AGB556/BISMUTH/CAD/Top Hot Assembly.stl

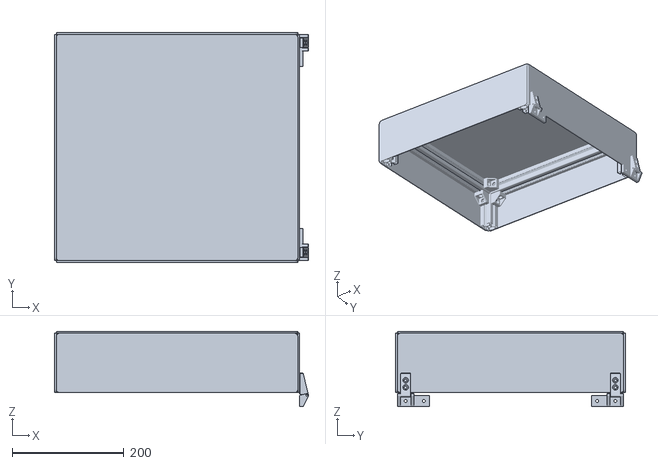
[picture p1: CAD file, 2024-08-06]
CAD/Top Hot Assembly.stl
454.0 x 411.1 x 134.4
