AGB556/BISMUTH/CAD/Hinge Assembly.step

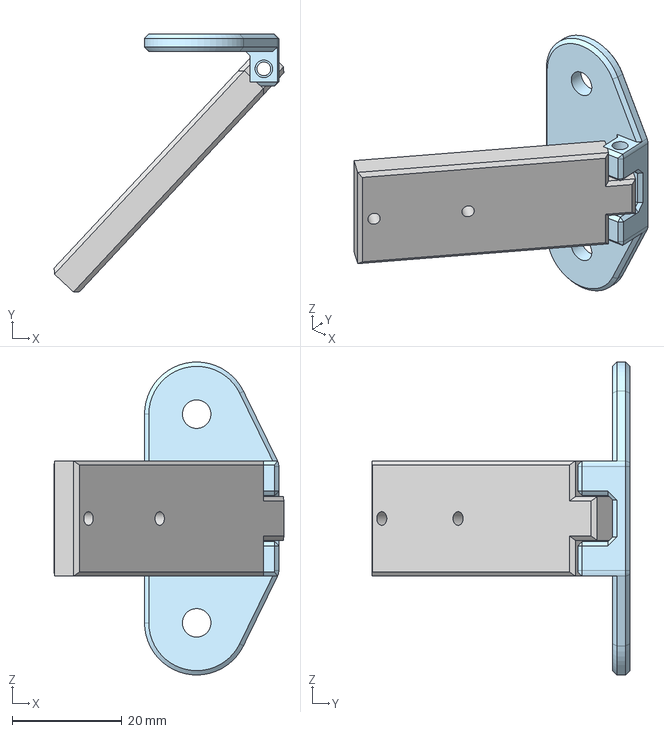
[picture p2: CAD file, 2024-07-04]
CAD/Hinge Assembly.step
41.9 x 47.1 x 57.1 mm
