AGB556/BISMUTH/CAD/Skirt Assembly.step

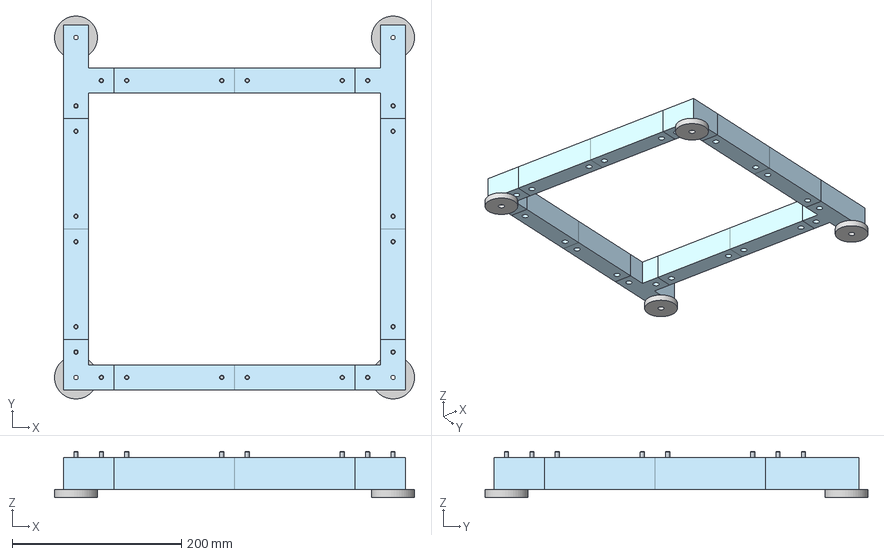
[picture p3: CAD file, 2024-07-02]
CAD/Skirt Assembly.step
425.6 x 452.6 x 54.5 mm
Hex socket head cap screw M5x0.80 x 25 x 24
