AGB556/BISMUTH/CAD/Anti Spool Cantilever.stl

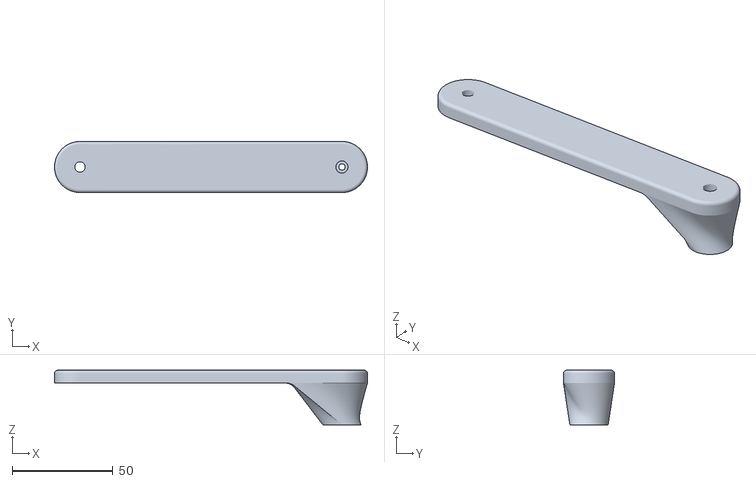
[picture p4: CAD file, 2024-08-18]
CAD/Anti Spool Cantilever.stl
155.6 x 25.4 x 27.2
