AGB556/BISMUTH/CAD/External Spool Holder.stl

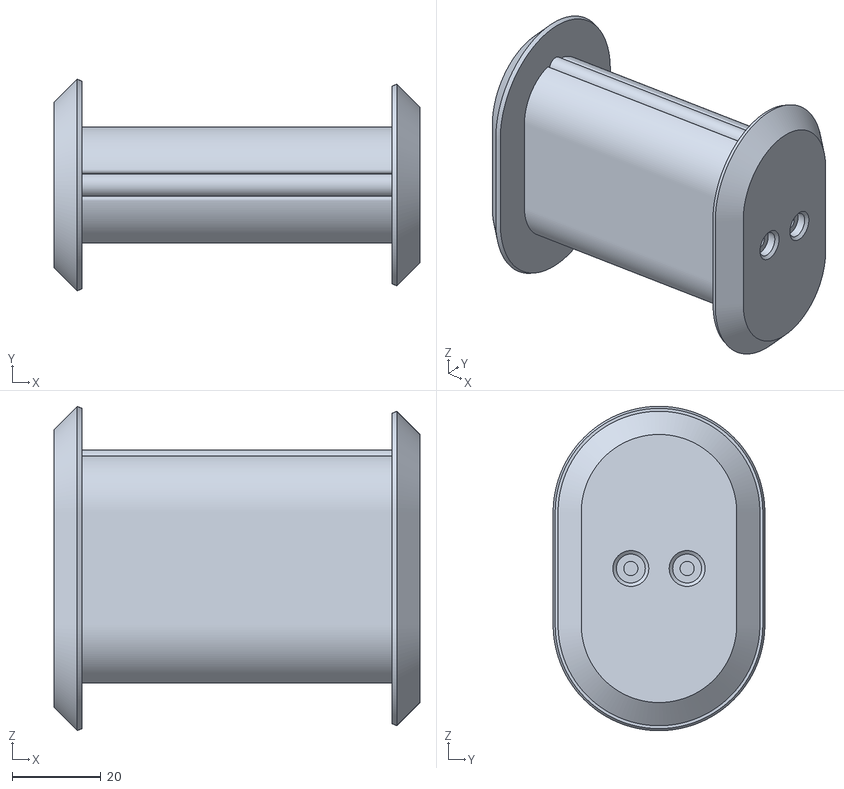
[picture p5: CAD file, 2024-08-16]
CAD/External Spool Holder.stl
82.5 x 47.8 x 73.2
