AGB556/BISMUTH/CAD/Spool.stl

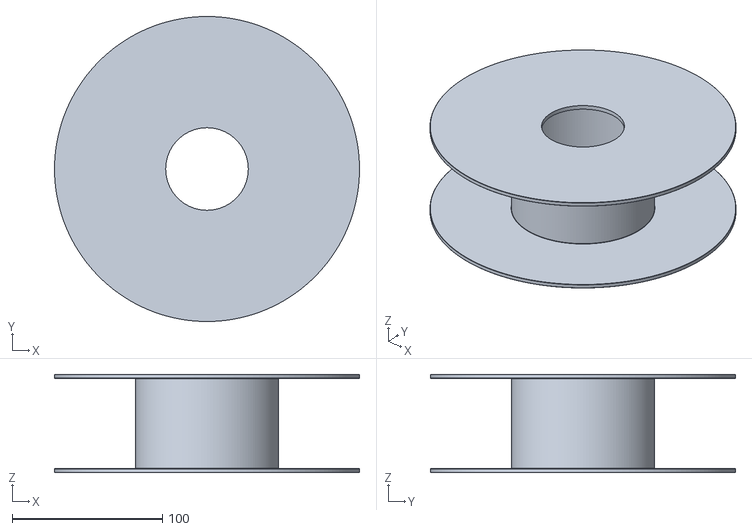
[picture p6: CAD file, 2024-08-16]
CAD/Spool.stl
203.2 x 203.2 x 65.5
