AGB556/BISMUTH/CAD/Top Electronics Panel.stl

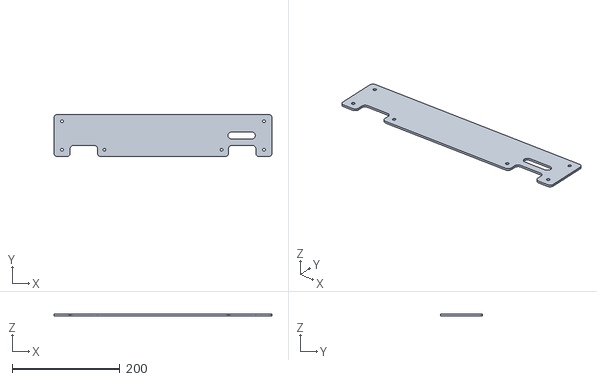
[picture p7: CAD file, 2024-08-15]
CAD/Top Electronics Panel.stl
404.8 x 78.5 x 3.17
