AGB556/BISMUTH/CAD/X-Y Parts - Sensorless Homing Block.stl

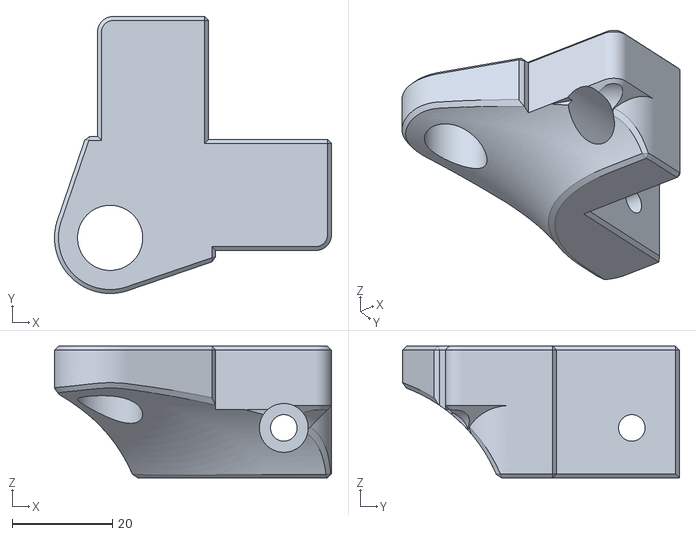
[picture p8: CAD file, 2024-08-14]
CAD/X-Y Parts - Sensorless Homing Block.stl
55.3 x 55.3 x 26.3
