AGB556/BISMUTH/CAD/Skirt Bottom Panel.stl

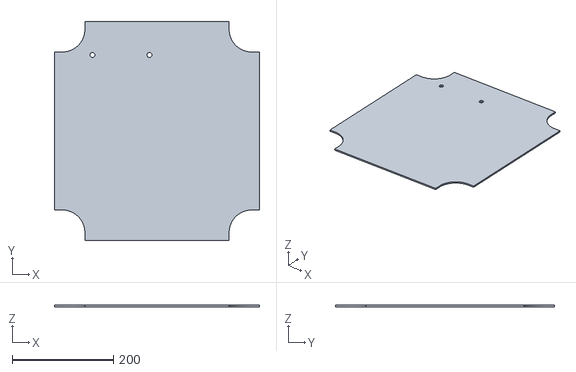
[picture p9: CAD file, 2024-08-13]
CAD/Skirt Bottom Panel.stl
404.8 x 431.8 x 3.17
