AGB556/BISMUTH/CAD/Bottom Panel.stl

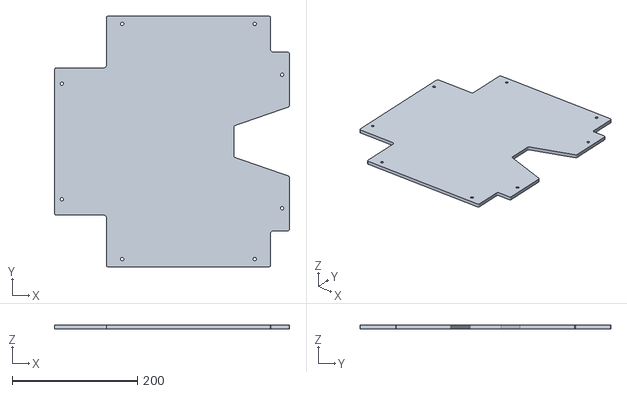
[picture p10: CAD file, 2024-08-13]
CAD/Bottom Panel.stl
374.6 x 400.1 x 6.35
