AGB556/BISMUTH/CAD/Door Hinge V3.stl

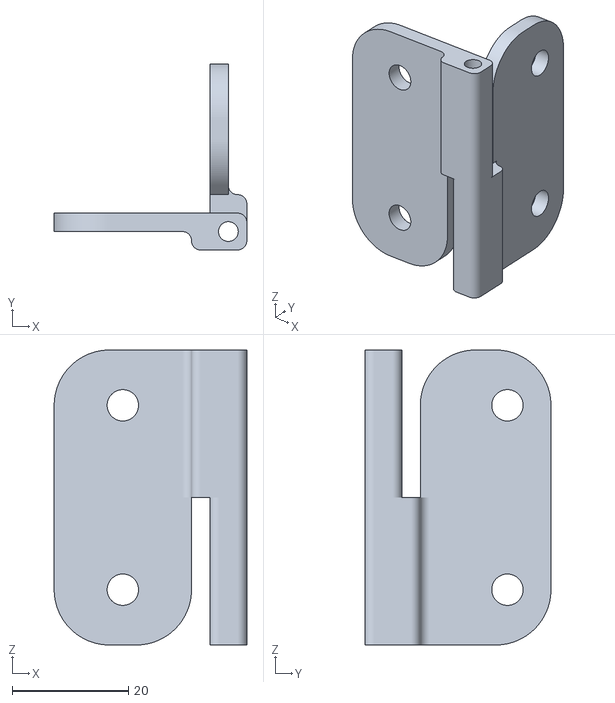
[picture p11: CAD file, 2024-08-13]
CAD/Door Hinge V3.stl
33.2 x 32.0 x 50.8
