AGB556/BISMUTH/CAD/Door Hinge Side Version.stl

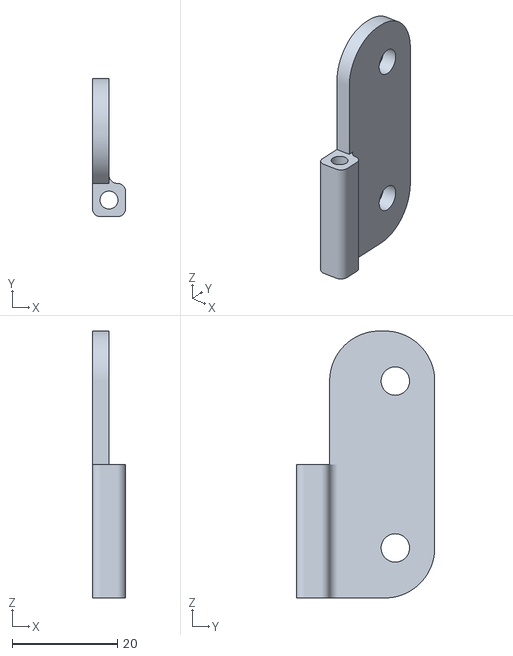
[picture p12: CAD file, 2024-08-12]
CAD/Door Hinge Side Version.stl
6.35 x 26.4 x 50.8
