AGB556/BISMUTH/CAD/Panels - Side Panel.stl

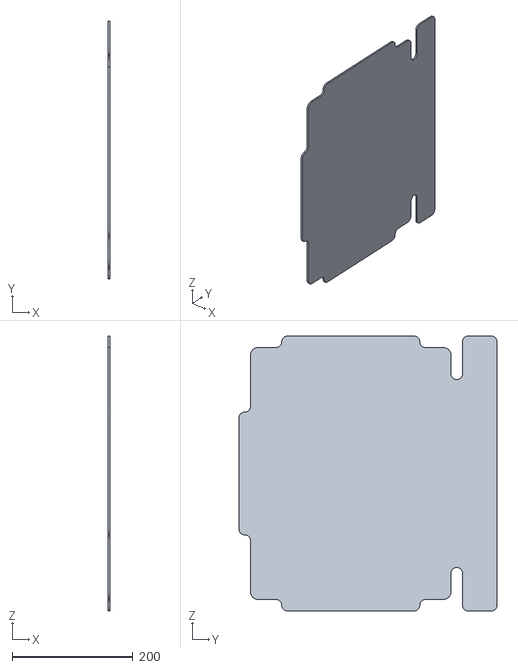
[picture p13: CAD file, 2024-08-12]
CAD/Panels - Side Panel.stl
3.17 x 427.2 x 455.2
