AGB556/BISMUTH/CAD/Panels - Door Panel.stl

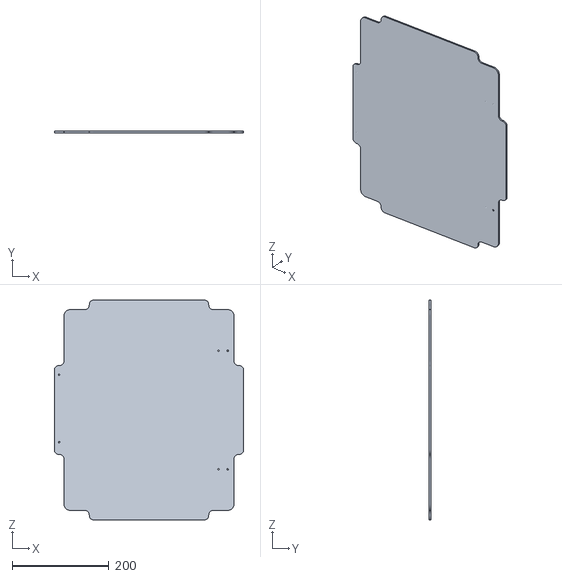
[picture p14: CAD file, 2024-08-12]
CAD/Panels - Door Panel.stl
392.4 x 3.17 x 455.9
