AGB556/BISMUTH/CAD/Nitehawk-36 Extruder Mount - Part 1.stl

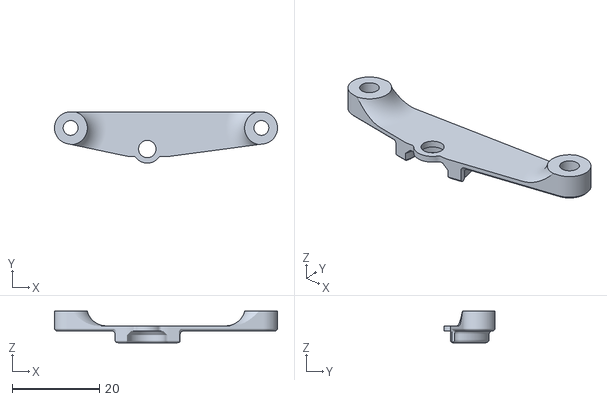
[picture p15: CAD file, 2024-08-10]
CAD/Nitehawk-36 Extruder Mount - Part 1.stl
51.2 x 11.8 x 7.25
