AGB556/BISMUTH/CAD/Top Hat Corner Piece.stl

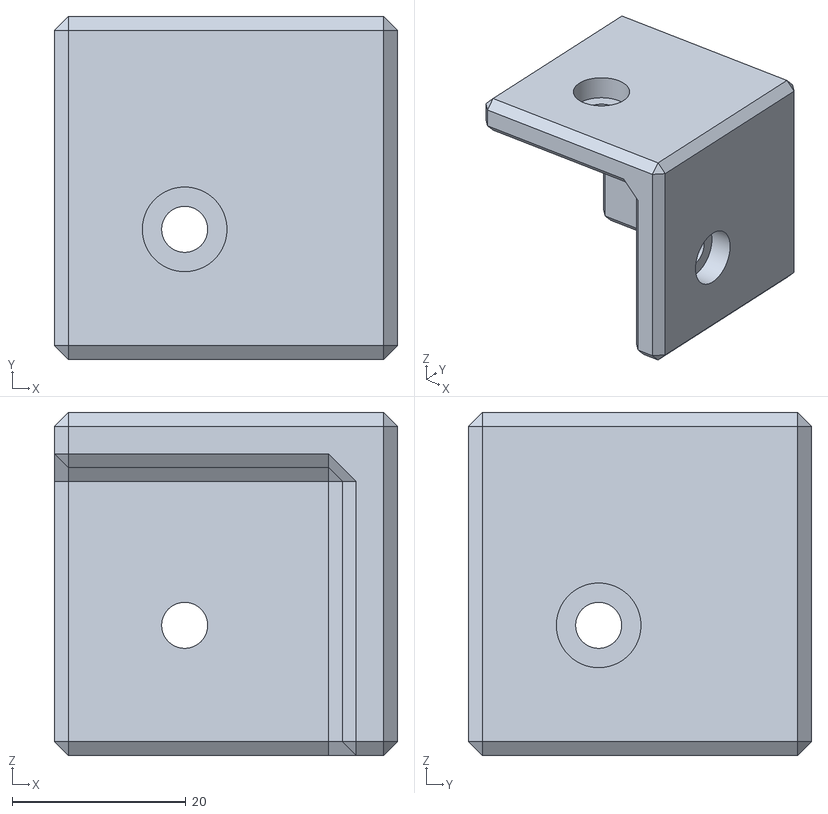
[picture p16: CAD file, 2024-08-08]
CAD/Top Hat Corner Piece.stl
39.5 x 39.5 x 39.5
