AGB556/BISMUTH/CAD/Panels - Electronics Panel.stl

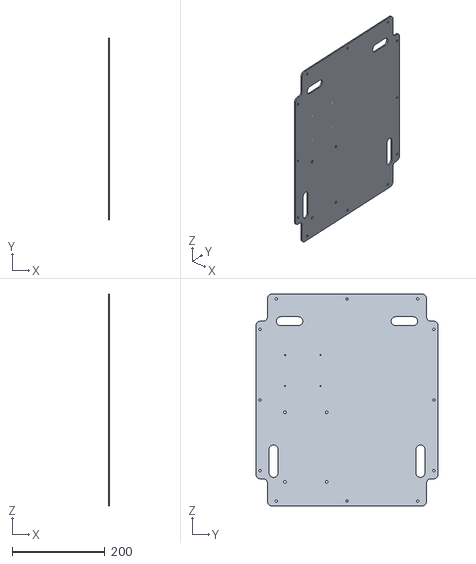
[picture p17: CAD file, 2024-07-27]
CAD/Panels - Electronics Panel.stl
3.17 x 392.9 x 457.2
