AGB556/BISMUTH/CAD/Raspberry Pi 4 Model B Case.stl

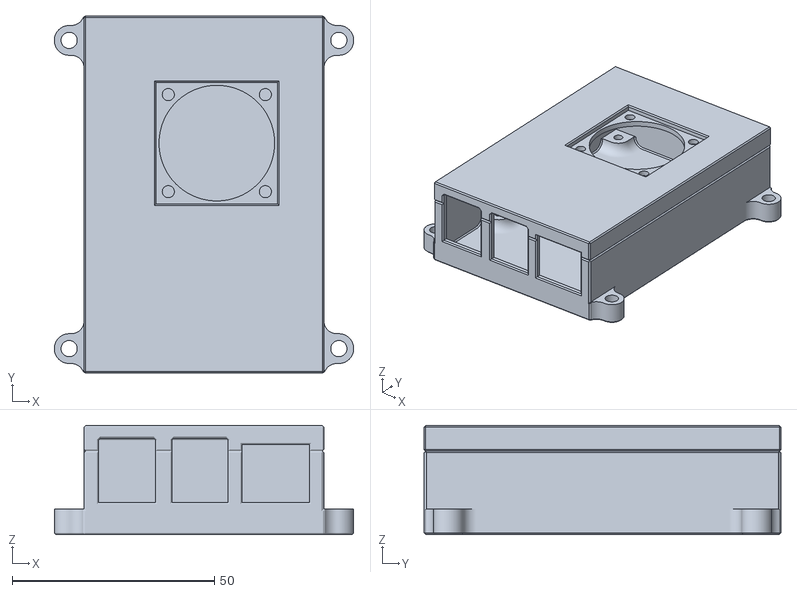
[picture p18: CAD file, 2024-07-25]
CAD/Raspberry Pi 4 Model B Case.stl
74.0 x 88.3 x 27.0
