AGB556/BISMUTH/CAD/Octopus Mount.stl

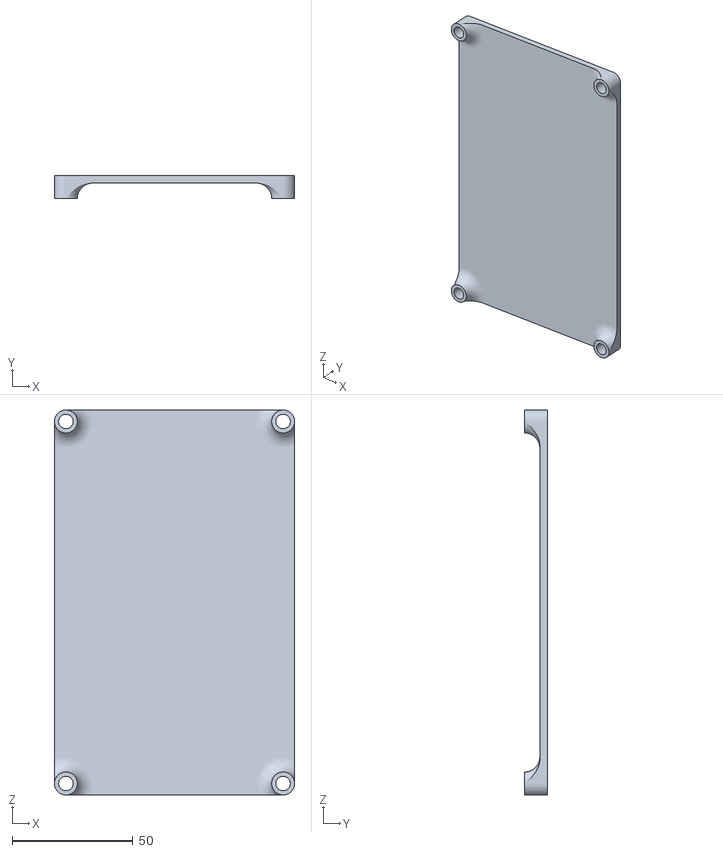
[picture p19: CAD file, 2024-07-14]
CAD/Octopus Mount.stl
99.5 x 9.53 x 159.5
