AGB556/BISMUTH/CAD/Panels - Back Panel.stl

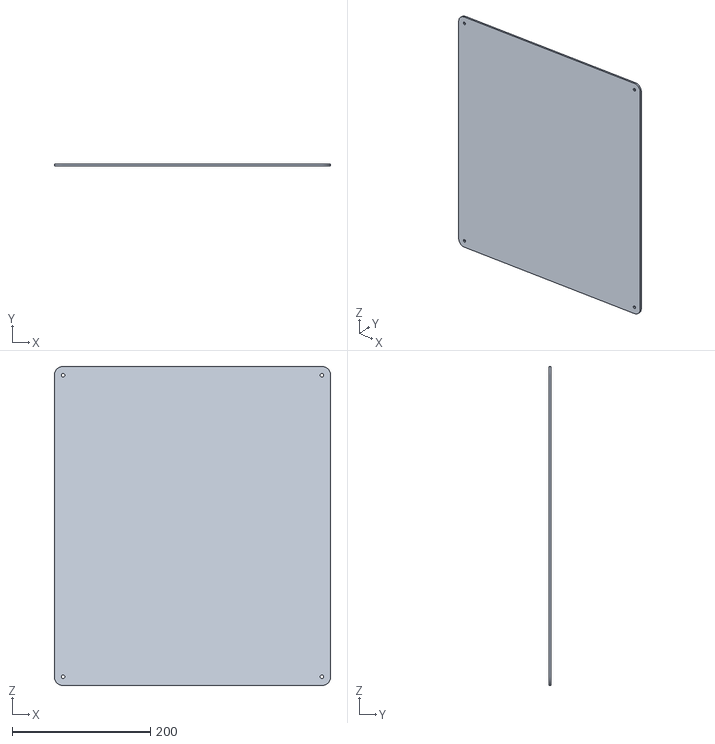
[picture p20: CAD file, 2024-07-14]
CAD/Panels - Back Panel.stl
400.2 x 3.17 x 461.8
