AGB556/BISMUTH/CAD/single z motor mount.step

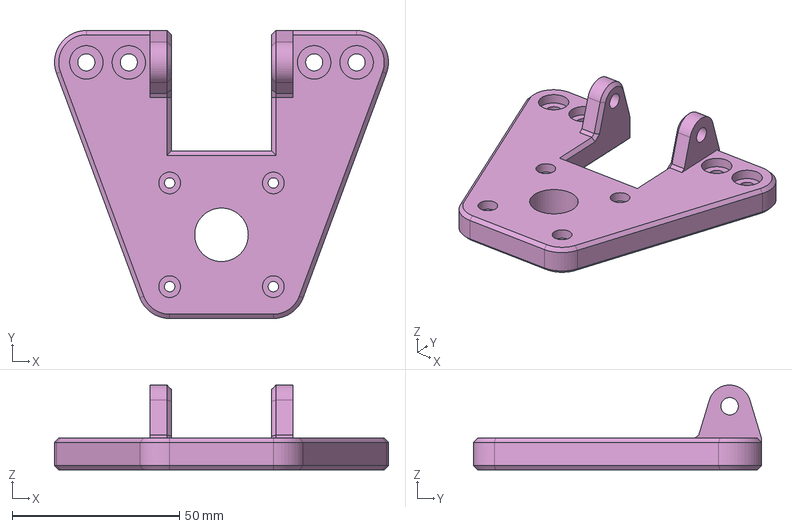
[picture p21: CAD file, 2024-07-06]
CAD/single z motor mount.step
99.8 x 86.1 x 25.4 mm
