AGB556/BISMUTH/CAD/Handle - Part 1.stl

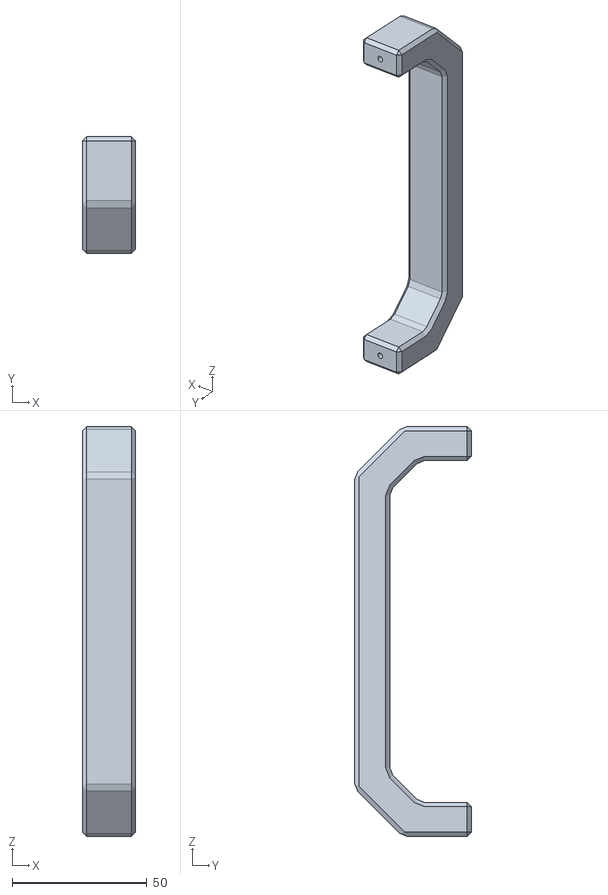
[picture p22: CAD file, 2024-07-06]
CAD/Handle - Part 1.stl
19.8 x 43.4 x 152.4
