AGB556/BISMUTH/CAD/Back and bottom plates.stl

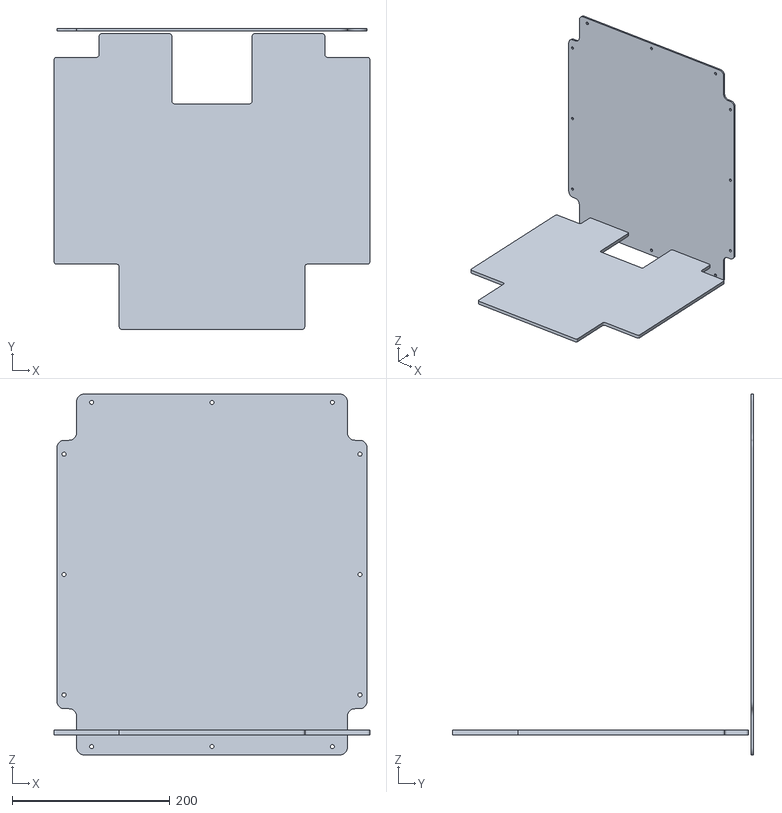
[picture p23: CAD file, 2024-07-03]
CAD/Back and bottom plates.stl
400.1 x 381.0 x 457.2
