AGB556/BISMUTH/CAD/90 Degree 3DP Bracket.step

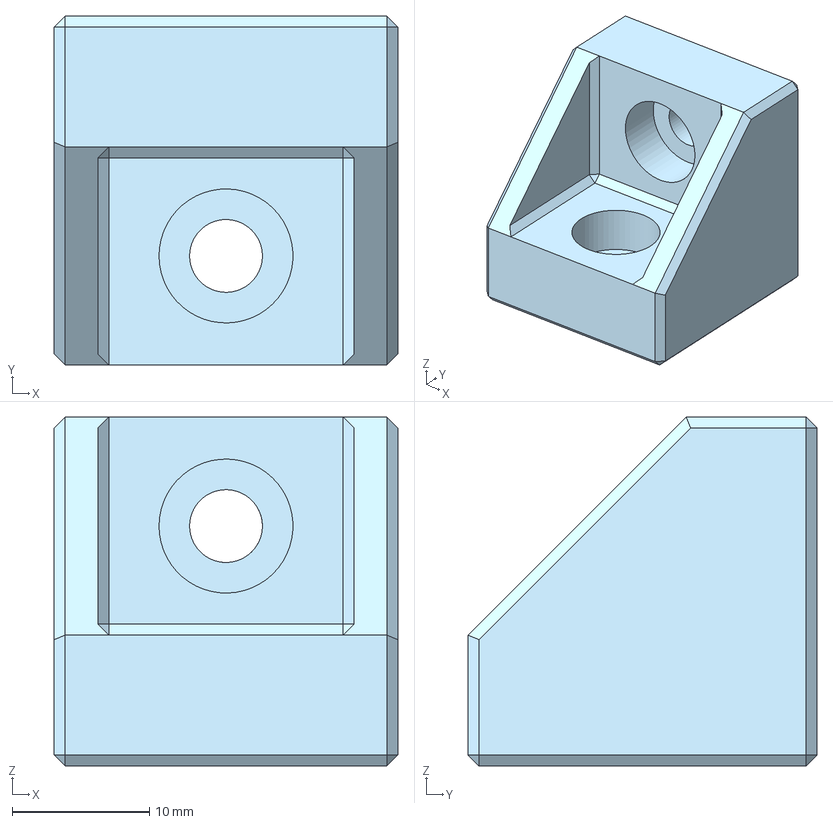
[picture p24: CAD file, 2024-07-03]
CAD/90 Degree 3DP Bracket.step
25.0 x 25.4 x 25.4 mm
