AGB556/BISMUTH/CAD/Side Panels.step

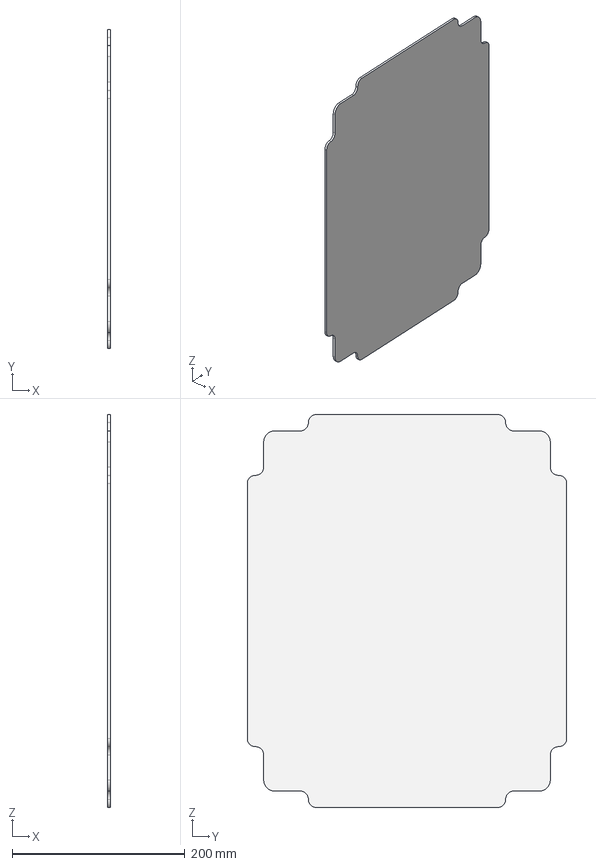
[picture p25: CAD file, 2024-07-02]
CAD/Side Panels.step
3.17 x 370.1 x 455.2 mm
