AGB556/BISMUTH/CAD/Extruder Mounting Plate.step

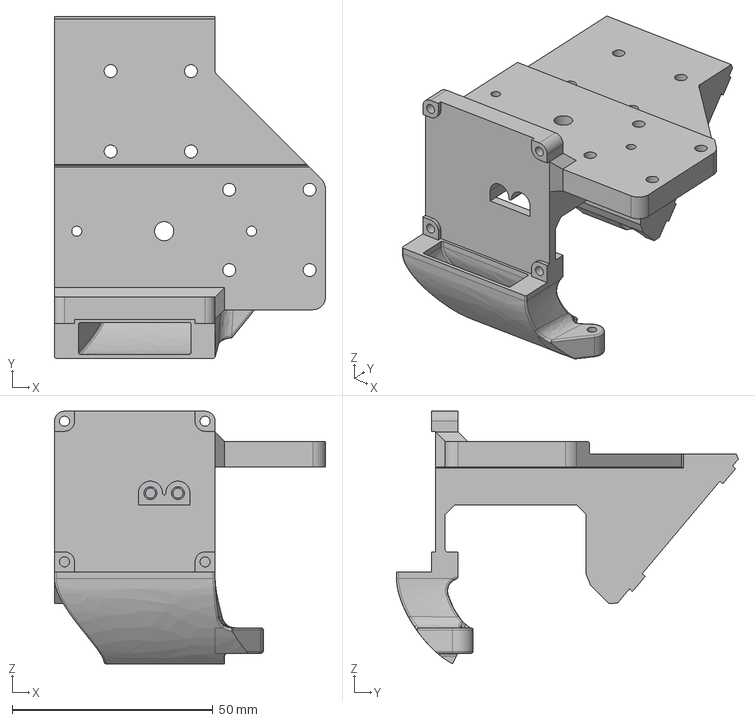
[picture p26: CAD file, 2024-06-30]
CAD/Extruder Mounting Plate.step
67.5 x 85.1 x 62.9 mm
