AGB556/BISMUTH/CAD/Mountable Fan Shroud.step

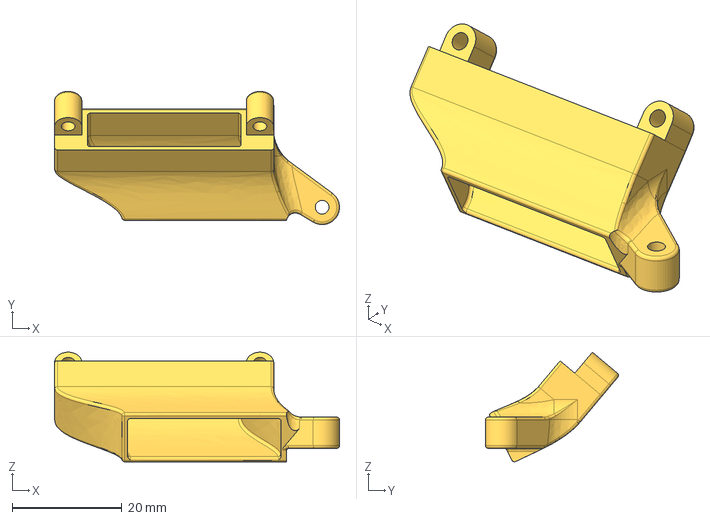
[picture p27: CAD file, 2024-06-30]
CAD/Mountable Fan Shroud.step
52.0 x 24.3 x 20.0 mm
