AGB556/BISMUTH/(list of files, cad)

Other CAD files:
CAD/Panels - Bottom Panel.stl
CAD/Electronics Panel.stl
CAD/single z motor.stl
CAD/Handle.step
CAD/90 Degree 3DP Bracket.stl
CAD/Hinge Assembly.stl
CAD/Side Panels.stl
CAD/Skirt Assembly.stl
Skirt Assembly.stl
