AGB556/BISMUTH/(commit log)

2024-06-28 6/27/2024 ~9:00ish
    this is the .step file for the extruder mounting plate that i was working on.
    [Extruder Mounting Plate.step]
2024-06-28 6/27/~10:30 work
    updated extruder mounting plate with second fan shroud
    [Extruder Mounting Plate.step]
2024-06-29 6/29/2024 3:20
    split the fan shrouds into 2 parts, added mounting holes to attach to the linear rails
    [Extruder Mounting Plate.step]
2024-06-30 6/29/2024 10:30
    updated my mounting plate with some chamfers for a stronger part and easier printability
    [Extruder Mounting Plate.step]
2024-06-30 6/29/2024 11:50
    added one of the two mounting holes for the beacon sensor
    [Extruder Mounting Plate.step]
2024-06-30 6/30/2024 2:00
    the updated file for the mountable fan shroud that also has a mounting hole for the beacon sensor mount
    [Mountable Fan Shroud.step]
2024-06-30 6/30/2024 6:00
    added fillets and modified the position of the mount to move the beacon down 2mm
    [Mountable Fan Shroud.step]
2024-06-30 6/30/2024 6:00
    added fillets and moved the beacon mount down 2mm to be in the recommended range
    [Extruder Mounting Plate.step]
2024-07-02 skirt parts and assembly v1
    my skirt for the 3d printer to leave room for electronics and allow space for cool decals
    [Skirt Assembly.step, Skirt Assembly.stl]
2024-07-02 modified how i designed these parts and added hardware and dampeners
    [Skirt Assembly.step, Skirt Assembly.stl]
2024-07-02 side panels
    these are the side panels for my printer to get it enclosed. the mesh with special gussets to create a heattight (in theory, not irl) seal to allow the chamber to get up to temperatures high enough to print engineering grade materials
    [Side Panels.step, Side Panels.stl]
2024-07-03 90 degree mounting bracket
    firmly mounts 2 3030 extrusions together
    [90 Degree 3DP Bracket.step, 90 Degree 3DP Bracket.stl]
2024-07-03 the back plate and bottom plate for the enclosure
    keeps heat in theoretically. made out of poly or acrylic probs
    [Back and bottom plates.stl]
2024-07-04 Door Hinge Assembly!
    files for the door hinge i made for my 3d printer that will be 3d printed.
    [Hinge Assembly.step, Hinge Assembly.stl]
2024-07-06 Handle
    This is the handle for my 3d printer enclosure door. meant to use 2 heat set inserts to mount. It is a very basic shape right now, it will become more complicated once i figure out a name.
    [Handle - Part 1.stl, Handle.step]
2024-07-06 Rename 90 Degree 3DP Bracket.step to CAD/90 Degree 3DP Bracket.step
    [90 Degree 3DP Bracket.step]
2024-07-06 Rename 90 Degree 3DP Bracket.stl to CAD/90 Degree 3DP Bracket.stl
    [90 Degree 3DP Bracket.stl]
2024-07-06 Rename Skirt Assembly.stl to CAD/Skirt Assembly.stl
    [Skirt Assembly.stl]
2024-07-06 Update and rename CAD/Skirt Assembly.stl to Skirt Assembly.stl
    [Skirt Assembly.stl]
2024-07-06 Rename Back and bottom plates.stl to CAD/Back and bottom plates.stl
    [Back and bottom plates.stl]
2024-07-06 Rename Extruder Mounting Plate.step to CAD/Extruder Mounting Plate.step
    [Extruder Mounting Plate.step]
2024-07-06 Rename Handle - Part 1.stl to CAD/Handle - Part 1.stl
    [Handle - Part 1.stl]
2024-07-06 Rename Hinge Assembly.step to CAD/Hinge Assembly.step
    [Hinge Assembly.step]
2024-07-06 Rename Hinge Assembly.stl to CAD/Hinge Assembly.stl
    [Hinge Assembly.stl]
2024-07-06 Rename Mountable Fan Shroud.step to CAD/Mountable Fan Shroud.step
    [Mountable Fan Shroud.step]
2024-07-06 Rename Side Panels.step to CAD/Side Panels.step
    [Side Panels.step]
2024-07-06 Rename Side Panels.stl to CAD/Side Panels.stl
    [Side Panels.stl]
2024-07-06 Rename Skirt Assembly.step to CAD/Skirt Assembly.step
    [Skirt Assembly.step]
2024-07-06 Update and rename Skirt Assembly.stl to CAD/Skirt Assembly.stl
    [Skirt Assembly.stl]
2024-07-06 z motor mount upgrade
    mounts to 3030 extruson @90 degree angle
    [single z motor mount.step, single z motor.stl]
2024-07-14 back panel for electronics
    added this back panel to be the true back panel of the printer. it will cover the electronics
    [Panels - Back Panel.stl]
2024-07-14 added holes to the electronics panels and made a quick mount for the BTT octopus board
    [Electronics Panel.stl, Octopus Mount.stl]
2024-07-19 added power switch mount and changed two parts
2024-07-21 nitehawk extruder pcb mount
    found cad for my pcb and also made a mount to mount it off of the motor.
    [Nitehawk-36 Extruder Mount - Part 1.stl]
2024-07-22 updated panel with usb adapter mount and moved electronics
    [Panels - Electronics Panel.stl]
2024-07-22 start of case making
    [Raspberry Pi 4 Model B Case.stl]
2024-07-22 top piece done, working on fan mounting
2024-07-25 final case update
    [Raspberry Pi 4 Model B Case.stl]
2024-07-27 holes to mount ras pi and slots for wires
    [Panels - Electronics Panel.stl]
2024-07-27 updated side panel to enclose electronics
    [Panels - Side Panel.stl]
2024-07-31 top hat tubes in the assembly
    [Top Hot Assembly.stl]
2024-08-01 added brackets and top plate
    [Top Hot Assembly.stl]
2024-08-04 panels done, only need hinges
    [Top Hot Assembly.stl]
2024-08-06 added hinges for the top hat
2024-08-06 modified the hinges a little bit, added holes in the side and top plates, added hardware
2024-08-08 top hat corner piece to better hold the top hat together
    [Top Hat Corner Piece.stl]
2024-08-10 updated mount to move the pcb to the front
    [Nitehawk-36 Extruder Mount - Part 1.stl]
2024-08-11 encloses better to trap heat more. Nevermore filter will go on top of this (nevermore not pictured due to large file size)
    [Panels - Bottom Panel.stl]
2024-08-12 modified panels to better trap heat. also sets up the v3 hinges
    [Panels - Door Panel.stl, Panels - Side Panel.stl]
2024-08-12 v3 hinges for a more low profile look
    [Door Hinge Side Version.stl]
2024-08-13 updated V3 hinges that are more low profile and fit the scheme of the printer
    [Door Hinge V3.stl]
2024-08-13 skirt bottom panel and the cover panel for the motors
    [Bottom Panel.stl, Skirt Bottom Panel.stl]
2024-08-14 updated skirt: bottom panel, bowden tube hole, bento box mount
2024-08-14 updated corner block for sensorless homing capability.
    [X-Y Parts - Sensorless Homing Block.stl]
2024-08-15 top elec panel to finish the enclosure
    [Top Electronics Panel.stl]
2024-08-16 more realistic spool model to test spacing and spool spinner
    [Spool.stl]
2024-08-16 updated spool spinner, holes for wiring
2024-08-16 external spool holder v1. holds the spool on the outside of the enclosure
    [External Spool Holder.stl]
2024-08-18 anti spool cantilever for the internal spool holder
    [Anti Spool Cantilever.stl]
2024-08-20 Update README.md
    shifted around the intro, added the x/y/toolhead and frame discription
2024-08-20 Update README.md
    made everything bullet points, added stuff about the extruder toolhead, better pictures
2024-08-20 Update README.md
    started work on skirt, added Z axis descrioption
